Tayne78/Battery-Management-System/README.md

# Battery-Management-System

Diploma thesis at the HTL St. Pölten. 2023/24

Authors: 
Thomas Kaiser
Markus Tucek
