Tayne78/Battery-Management-System/Slave-Modules/Hardware/Components/Slave_PCB.xlsx

1x Slave |  |  |  |  |  | Anzahl für 20 Platinen (2x Slaves)
Comment | Description | Designator | Footprint | Anzahl | Wert | Anzahl | RS | Reichelt | Preis pro Stück (€) | Gesamtpreis (€)
Cap | Capacitor | CA1, CA1_1, CA11, CA11_1, CG1, CG1_1, CRST1, CRST1_1 | 0603 | 8 | 100nF | 160 | 2423917 (https://at.rs-online.com/web/p/products/2423917/) |  | 0.021 | 4.2
Cap | Capacitor | CA21, CA21_1 | 0603 | 2 | 10nF | 40 | 2423912 (https://at.rs-online.com/web/p/products/2423912/) |  | 0.01 | 1
Cap | Capacitor | CBOT1, CBOT1_1, CTOP1, CTOP1_1 | 0603 | 4 | 100pF | 80 | 1356524 (https://at.rs-online.com/web/p/keramik-vielschichtkondensatoren/1356524) |  | 0.012 | 1.2
Cap | Capacitor | CVCC1, CVCC1_1 | 1206 | 2 | 10µF | 40 | 1721545 |  | 0.102 | 5.1
ATTINY261A-SU | Integrated Circuit | IC11, IC11_1 | TSSOP-20T (MO-153 AC) | 2 |  | 40 |  | ATTINY 261A-SU (https://www.reichelt.at/at/de/8-bit-attiny-avr-risc-mikrocontroller-2-kb-20-mhz-so-20-attiny-261a-su-p121844.html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) | 1.27 | 50.76
B2B-PH-SM4-TB_LF__SN_(Buchse) | Connector | J21, J21_1 | JST-PHR | 2 |  | 40 |  | JST PH2P STS (https://www.reichelt.at/at/de/jst-stiftleiste-smd-gerade-1x2-polig-ph-jst-ph2p-sts-p185063.html?nbc=1) | 0.22 | 8.72
JST PH2P BU(Stecker) | Connector | J21, J21_1 | / | 2 |  | 40 |  | JST PH2P BU (https://www.reichelt.at/at/de/jst-buchsengehaeuse-1x2-polig-ph-jst-ph2p-bu-p185041.html?&nbc=1) | 0.05 | 2
JST PH2P BU(Stecker Crimpkontakt) | Connector | J21, J21_1 | / | 4 |  | 80 |  | JST PH CKB (https://www.reichelt.at/at/de/jst-crimpkontakt-buchse-ph-jst-ph-ckb-p185071.html?&nbc=1) | 0.06 | 4.72
SML-P24 | Dual Color LED | LED11, LED11_1 | 1010 LED | 2 |  | 40 | 1246882 (https://at.rs-online.com/web/p/products/1246882/) |  | 0.32 | 16
NTR4503NG | MOSFET (N-Channel) | Q11, Q11_1 | SOT-23 (TO-236) | 2 |  | 40 | 7804751 (https://at.rs-online.com/web/p/products/7804751/) |  | 0.083 | 4.15
Res | Resistor | RA11, RA11_1, RA21, RA21_1, RFB1, RFB1_1, RFT1, RFT1_1, RPD1, RPD1_1 | 0603 | 10 | 100K | 200 | 1978010 (https://at.rs-online.com/web/p/products/1978010/) |  | 0.008 | 4
Res | Resistor | RAVCC1, RAVCC1_1, RVCC1, RVCC1_1 | 0603 | 4 | 47R | 80 | 9013513 (https://at.rs-online.com/web/p/products/9013513/) |  | 0.002 | 0.2
Res | Resistor | RBB1, RBB1_1, RBT1, RBT1_1 | 0603 | 4 | 470K | 80 | 2426811 (https://at.rs-online.com/web/p/products/2426811/) |  | 0.005 | 0.5
Res | Resistor | RDB1, RDB1_1, RDT1, RDT1_1 | 0603 | 4 | 10K | 80 | 1995443 (https://at.rs-online.com/web/p/products/1995443/) |  | 0.008 | 0.8
Res | Resistor | RG1, RG1_1, RLED1, RLED1_1 | 0603 | 4 | 1k | 80 | 6789875 |  | 0.004 | 0.4
Res | Resistor | RL1, RL1_1 | 1020 (Reversed) | 2 | 36R | 40 | 2280509 (https://at.rs-online.com/web/p/products/2280509/) |  | 0.601 | 24.04
MMST2907A-7-F | PNP | TB1, TB1_1 | SOT-323 (SC-70) | 2 |  | 40 | 7514543 (https://at.rs-online.com/web/p/products/7514543/) |  | 0.024 | 2.4
BC817-40W-7 | NPN | TT1, TT1_1 | SOT-323 (SC-70) | 2 |  | 40 | 7513493 (https://at.rs-online.com/web/p/products/7513493/) |  | 0.012 | 1.2
Leiterplatte |  |  |  | 1 |  | 20 |  |  | 0.331 | 6.62
Stencil |  |  |  |  |  | 1 |  |  |  | 6.6
Lieferung PCB |  |  |  |  |  |  |  |  |  | 17
 |  |  |  |  |  |  |  |  | Gesamtpreis (€) | 161.61
 |  |  |  |  |  |  |  |  | Preis pro Platine(2xSlave) (€) | 8.08
