Tayne78/Battery-Management-System/(list of files, drawings)

Other design files:
Master-Module/Hardware/Altium Libraries/BMS_Master.PcbLib
Master-Module/Hardware/Altium Libraries/BMS_Master.SchLib
Master-Module/Hardware/Master_PCB/Master_PCB_V2/BMS_Master.PrjPcb
Master-Module/Hardware/Master_PCB/Master_PCB_V2/Master_PCB.PcbDoc
Master-Module/Hardware/Master_PCB/Master_PCB_V2/Master_Schematik.SchDoc
Slave-Modules/Hardware/Altium Libraries/Slave_Programmer.PcbLib
Slave-Modules/Hardware/Altium Libraries/Slave_Programmer.SchLib
Slave-Modules/Hardware/Altium Libraries/SlaveLib.PcbLib
Slave-Modules/Hardware/Altium Libraries/SlaveLib.SchLib
Slave-Modules/Hardware/Slave_PCB/Slave_PCB_V1/Slave_PCB_V1.PrjPcb
Slave-Modules/Hardware/Slave_PCB/Slave_PCB_V1/Slave_Schematic2.SchDoc
Slave-Modules/Hardware/Slave_PCB/Slave_PCB_V1/Slave_Schematic.SchDoc
Slave-Modules/Hardware/Slave_PCB/Slave_PCB_V2/Slave_PCB.PcbDoc
Slave-Modules/Hardware/Slave_PCB/Slave_PCB_V2/Slave_PCB_V2.PrjPcb
Slave-Modules/Hardware/Slave_PCB/Slave_PCB_V2/Slave_Schematic2.SchDoc
Slave-Modules/Hardware/Slave_PCB/Slave_PCB_V2/Slave_Schematic.SchDoc
Slave-Modules/Hardware/Slave_Programmer/Programmer.PcbDoc
Slave-Modules/Hardware/Slave_Programmer/Programmer.SchDoc
Slave-Modules/Hardware/Slave_Programmer/Sheet1.SchDoc
Slave-Modules/Hardware/Slave_Programmer/Slave_Programmer.PrjPcb
