Tayne78/Battery-Management-System/(commit log)

2023-08-13 initial project version
    [BMS_Master.PcbLib, BMS_Master.PrjPcb, BMS_Master.SchLib, Master_PCB.PcbDoc, Master_Schematik.SchDoc, Programmer.PcbDoc, Programmer.SchDoc, Sheet1.SchDoc]
2023-09-09 Slave V2
    first changes, Transistor pins corrected, capacitors changed
    [Slave_PCB.PcbDoc, Slave_PCB_V2.PrjPcb, Slave_Schematic.SchDoc, Slave_Schematic2.SchDoc]
2023-09-27 Added Footprints and Schematics
    [BMS_Master.PcbLib, BMS_Master.SchLib]
2023-10-07 updated Libraries
    [BMS_Master.PcbLib, BMS_Master.SchLib]
2023-10-17 changed Relay
    [Master_Schematik.SchDoc]
2023-10-24 Updated Schematik
    [Master_Schematik.SchDoc]
2023-11-08 Layout PCB
    [Master_PCB.PcbDoc, Master_Schematik.SchDoc]
2023-11-15 Finished Schematik
    [BMS_Master.PrjPcb, Master_PCB.PcbDoc, Master_Schematik.SchDoc]
2023-11-29 Add files via upload
    Added Planes
    [Master_PCB.PcbDoc]
2023-12-18 finished PCB
    [Master_PCB.PcbDoc]
